brainboxemb/lib.scad.mechint/doc/10-00-plan.md

# lib.scad.mechint plan

## Purpose

This is the operational source for current/future work in the reusable
mechanical-interface library. Completed functional history belongs in
[../CHANGELOG.md](../CHANGELOG.md).

## Current position

The sliding-dovetail interface is the established reusable component. It
supports base male/female mating geometry plus optional entry-slot, locking,
release-access, printable release-shape and centered hinge-relief features.

Migration 011 issue #34 is complete and qualified on exact main. The current
owner step is the `v0.2.4` patch release candidate for that consumer-rollout
baseline.

The release adopts `tool.git-project v0.2.14`, `tool.scad-project v0.15.11`,
`lib.scad.forge v0.3.1` and `lib.scad.util v0.4.1`, together with managed root
launchers, current self/reusable workflow naming and the shared numbered
documentation structure.

No sliding-dovetail geometry or public API semantics change in `v0.2.4`.

## Working method

1. inspect current source, open issues/PRs, live CI and generated evidence;
2. read the component design and manual before changing interface semantics;
3. keep fit dimensions separate from Boolean/modeling overlap;
4. preserve the public top-level API boundary;
5. add product-independent behavior here and product placement in consumers;
6. inspect fit/section evidence when the change is geometric.

## Information sources

| Question | Authority |
| --- | --- |
| Current/future library work | this plan |
| Shared working conventions | `brainboxemb.meta/AGENTS.md` |
| Interface contracts/boundaries | [30-00-specification.md](30-00-specification.md) |
| Repository architecture | [40-00-design.md](40-00-design.md) |
| Detailed geometry | `openscad/sliding-dovetail/design/design.md` |
| Consumer usage/API reference | `openscad/sliding-dovetail/manual.md` |
| Verification strategy/status | [50-00-verification.md](50-00-verification.md) |
| Exact dependency/tool state | config, gitlinks, live Actions and provenance |
| Completed history | [../CHANGELOG.md](../CHANGELOG.md) |
