brainboxemb/lib.scad.mechint/doc/20-02-user.md

# lib.scad.mechint user manual

## Use the library

Consumers import the public entrypoint:

```scad
use <openscad/sliding_dovetail.scad>

joint = sliding_dovetail_create(...);
sliding_dovetail_male_build(joint, slide_len_mm = 16);
sliding_dovetail_female_cutter(joint, slide_len_mm = 16);
```

The same interface object drives mating geometry so male/female dimensions,
clearance, optional entry-slot behavior and lock configuration stay coherent.

## Detailed sliding-dovetail guidance

The full consumer-facing reference remains beside the component source:

- [Sliding-dovetail manual](../openscad/sliding-dovetail/manual.md)
- [Sliding-dovetail design](../openscad/sliding-dovetail/design/design.md)

Use the manual for exact API/usage guidance. Use the design document when the
mechanical construction or coordinate system matters.

## Dependency boundary

`lib.scad.forge` supplies generic modeling mechanics only. Mechanical-interface
fit and locking semantics remain owned by mechint.

`lib.scad.util` is used only for section-inspection views and does not define
the mechanical interface.

## Versions

Pin an explicit released mechint version. The library itself pins exact released
Forge/util/tooling dependencies through `project.yml` plus committed gitlinks.
