brainboxemb/lib.scad.mechint/doc/README.md

# lib.scad.mechint documentation

This directory is the maintained engineering-documentation index for
`lib.scad.mechint`.

The library owns reusable mechanical interfaces. Product-specific placement,
load-path and assembly decisions stay with consumers.

## Reading order

- [10-00 — Plan](10-00-plan.md) — current work, authorities and sequence.
- [20-00 — Manuals](20-00-manuals.md) — development and consumer guidance.
- [20-01 — Development](20-01-development.md) — maintain, qualify and release mechint.
- [20-02 — User](20-02-user.md) — consume the public mechanical-interface API.
- [30-00 — Specification](30-00-specification.md) — interface purpose and contracts.
- [40-00 — Design](40-00-design.md) — repository/API architecture.
- [50-00 — Verification](50-00-verification.md) — reusable-interface qualification.

Sliding-dovetail detailed geometry remains beside source at
[../openscad/sliding-dovetail/design/design.md](../openscad/sliding-dovetail/design/design.md).
The detailed consumer manual remains at
[../openscad/sliding-dovetail/manual.md](../openscad/sliding-dovetail/manual.md).
