brainboxemb/lib.scad.mechint/vrf/openscad/02-sliding-dovetail-approach.scad

use <../../openscad/sliding-dovetail/reference/sliding_dovetail_reference.scad>

reference =
    sliding_dovetail_reference_create();

$vpt = [2, 1.5, 0];
$vpr = [72, 0, 35];
$vpd = 90;

sliding_dovetail_reference_pair_build(
    reference,
    position = "approach"
);
