brainboxemb/lib.scad.mechint/openscad/sliding-dovetail/render/sliding-dovetail-assembled.scad

use <../sliding_dovetail_render.scad>

$vpt = [10, 1.5, 0];
$vpr = [72, 0, 35];
$vpd = 72;

sliding_dovetail_design(view = "assembled");
