brainboxemb/lib.scad.mechint/openscad/sliding-dovetail/render/sliding-dovetail-female.scad

use <../sliding_dovetail_render.scad>

$vpt = [10, 3, 0];
$vpr = [72, 0, 35];
$vpd = 70;

sliding_dovetail_design(view = "female");
