brainboxemb/lib.scad.mechint/openscad/sliding-dovetail/render/sliding-dovetail-lock-male.scad

use <../sliding_dovetail_render.scad>

$vpt = [0, 1.5, 0];
$vpr = [72, 0, 35];
$vpd = 55;

sliding_dovetail_lock_design(view = "male");
