brainboxemb/lib.scad.mechint/openscad/sliding-dovetail/render/sliding-dovetail-pair.scad

use <../sliding_dovetail_render.scad>

$vpt = [2, 1.5, 0];
$vpr = [72, 0, 35];
$vpd = 90;

sliding_dovetail_design(view = "approach");
