brainboxemb/lib.scad.mechint/vrf/fixtures/export/12-sliding-dovetail-lock-female-cutaway.scad

use <../../../openscad/sliding_dovetail.scad>
use <../../../openscad/sliding-dovetail/reference/sliding_dovetail_reference.scad>
use <00-sliding-dovetail-fixture-orientation.scad>

joint =
    sliding_dovetail_create(
        is_locking_enabled = true,
        lock_spring_len_mm = 5.5,
        lock_has_back_clearance = true,
        lock_has_release_access = true
    );

reference =
    sliding_dovetail_reference_create(
        obj = joint
    );

// Keep the +Z half in native coordinates so the center plane exposes the
// threshold and spring cavity, then orient the resulting fixture for viewing.
sliding_dovetail_fixture_female_inspection(reference)
    intersection() {
        sliding_dovetail_reference_female_build(reference);

        translate([-1, -1, 0])
            cube([
                reference.female_block_len_mm + 2,
                reference.female_block_depth_mm + 2,
                reference.block_width_mm / 2 + 1
            ]);
    }
