brainboxemb/lib.scad.mechint/(list of files, cad)

Other CAD files:
openscad/sliding-dovetail/sliding_dovetail.scad
openscad/sliding-dovetail/render/sliding-dovetail-assembled-section.scad
openscad/sliding-dovetail/render/sliding-dovetail-lock-assembled.scad
openscad/sliding-dovetail/render/sliding-dovetail-male.scad
vrf/fixtures/export/00-sliding-dovetail-hinge-fixture.scad
vrf/fixtures/export/13-sliding-dovetail-lock-assembled.scad
vrf/fixtures/export/16-sliding-dovetail-lock-hinge-female-cutaway.scad
vrf/fixtures/export/17-sliding-dovetail-lock-hinge-assembled-cutaway.scad
vrf/fixtures/export/01-sliding-dovetail-male-test-piece.scad
vrf/fixtures/export/02-sliding-dovetail-female-test-block.scad
vrf/fixtures/export/10-sliding-dovetail-lock-male-test-piece.scad
vrf/fixtures/export/11-sliding-dovetail-lock-female-test-block.scad
