brainboxemb/lib.scad.mechint/openscad/sliding-dovetail/manual.md

# Sliding dovetail

The interface is aimed at compact **FDM-printed mechanical parts**.

## Native orientation

```text
X = slide_len_mm / insertion direction
Y = profile depth
Z = profile width_mm

female entry side = -X
insertion motion = +X
female end-stop side = +X
```

The male mouth lies at `Y=0`; the wider root lies toward `+Y`.

## Default interface

| Parameter | Default |
| --- | ---: |
| Root / maximum male width | 10.0 mm |
| Profile height | 3.0 mm |
| Flank angle | 20° |
| Root land depth | 0 mm / disabled |
| Mouth land depth | 0 mm / disabled |
| Derived male mouth width | 7.82 mm |
| Female clearance | 0.20 mm |
| Axial clearance | 0.25 mm |
| Boolean overlap (`extra_mm`) | 0.01 mm |
| Female entry slot | 0 mm / disabled |
| Locking | disabled |

## Parameter meaning

`angle_deg` directly describes the mechanical flank angle.

`root_land_depth_mm` optionally replaces the final part of each angled flank with
a straight land at the wide/root end. `mouth_land_depth_mm` does the same at the
narrow/mouth end before the angled flank begins. Values of `0` preserve the
original trapezoidal profile exactly.

The mouth width is derived from `width_mm`, the remaining sloped depth
`height_mm - root_land_depth_mm - mouth_land_depth_mm`, and `angle_deg`.

The two lands are useful for side-printed parts where a fully angled profile
would otherwise begin or finish on a sharp first-layer edge.

`clearance_mm` and `axial_clearance_mm` are fit dimensions.

`extra_mm` exists only to make OpenSCAD unions and differences robust at shared
boundaries. It is not part of the nominal mating dimensions.

### Female entry slot

`entry_slot_len_mm` optionally adds a straight rectangular subtraction volume
ahead of the female channel on the fixed `-X` entry side. Its width and depth
come from the complete clearanced female root envelope, so a male dovetail can
sit ahead of the channel before sliding in.

The parameter is a length along X only. A value of `0` preserves the ordinary
female cutter. The male builder ignores this setting.

When locking is enabled, a non-zero entry slot also opens the short transverse
relief at the female spring start. This keeps the lock tongue U-shaped even
though material may continue ahead of the mating channel.

For example, a 16 mm male can be given a 16 mm approach pocket:

```scad
joint = sliding_dovetail_create(
    entry_slot_len_mm = 16
);

sliding_dovetail_female_cutter(
    joint,
    slide_len_mm = 16
);
```

`sliding_dovetail_female_slide_len_mm()` continues to return only the mating channel
length. Use `sliding_dovetail_female_total_len_mm()` when host geometry must
include both channel and entry slot.

## Locking

Locking is configured on the same top-level interface object:

```scad
joint = sliding_dovetail_create(
    is_locking_enabled = true,
    lock_has_back_clearance = true,
    lock_has_release_access = true
);
```

The library creates the lower-level lock and spring configuration internally.

`lock_entry_offset_mm` measures the start of the female threshold ramp from the
fixed -X entry side. Its default is 0 mm, so the ramp starts directly at the
edge. In the assembled interface the male recess is derived from that same
entry-side definition.

The lock combines a recess in the male with a ramped threshold in the female
channel roof. Two longitudinal relief cuts form the sides of the U-shaped
tongue. When the spring starts at a physical female edge, that edge is already
the open end of the U. If `lock_entry_offset_mm > 0` or
`entry_slot_len_mm > 0`, the library also cuts the short transverse relief
needed to free the tongue at its entry end.

`lock_has_back_clearance = true` cuts the flex cavity behind the tongue.
With it disabled, the spring can keep a flat outer/rear face.

For a thick host, `lock_spring_hinge_len_mm > 0` enables a **two-sided**
hinge relief. `lock_spring_hinge_thickness_mm` is the total thickness of the
short flex web that remains between the two opposing pockets.

The complete locking-threshold region and the fixed root stay full-depth. From
the fixed root toward the locking lip, both faces use the same profile:

1. a mostly straight root wall;
2. a local 45-degree chamfer;
3. a short flat central-web land;
4. a calculated return ramp;
5. a full-depth flat land under the threshold/lip.

`lock_spring_hinge_len_mm` is split equally between the 45-degree chamfer run
and the flat central-web land. The two pockets remove
`(lock_spring_thickness_mm - lock_spring_hinge_thickness_mm) / 2` from each face,
placing the remaining web around the middle of the tongue. The return-ramp angle
is derived from the remaining spring length and is limited to 45 degrees.

For a 4 mm tongue, `lock_spring_hinge_len_mm = 2` gives the intended 1 x 1 mm
45-degree chamfer followed by 1 mm flat land on each side. A centered web of
about 1 mm would then leave about 1.5 mm relief depth per face. The verification
model keeps the existing 3.3 mm tongue and 0.8 mm web so the same principle can
be inspected at the current library test dimensions. A hinge length of 0 keeps
the previous geometry exactly.

The threshold insertion ramp is independently tunable with
`lock_ramp_len_mm`. With `lock_has_release_access = true`, the recess continues
to the male -X edge with the same width as the recess itself. A small flat
screwdriver can use that opening to lift the female tongue.

The released/default opening is rectangular:

```scad
lock_release_shape = "rectangular"
```

For the side-printed male part the opening can instead use a centered
trapezoidal X/Z profile:

```scad
joint = sliding_dovetail_create(
    is_locking_enabled = true,
    lock_has_release_access = true,
    lock_release_depth_mm = 0.6,
    lock_release_shape = "trapezoid",
    lock_release_taper_angle_deg = 45
);
```

The released rectangular access opening and lock recess are always cut in full.
Trapezoid mode then removes two additional symmetric triangular wedges across
the complete visible release zone, from the male -X/trailing edge through the
far end of the recess. It therefore only removes extra material; it never
narrows or replaces the functional baseline opening.

`lock_release_taper_angle_deg` is measured in the native X/Z profile. At 45
degrees each wedge grows by 1 mm in Z for every 1 mm of nominal release-zone run
in X. The native-Y release depth remains constant. The wedge cutters overlap the baseline opening and extend slightly past the
actual male outer face (including the male body's normal Boolean `extra_mm`)
so coplanar boundaries cannot leave a thin residual wall.

## Male mating relief

A consuming body may overlap the male interface for a robust union while its
flanks still need to remain exposed. Use the profile-derived cutter instead of
duplicating dovetail math:

```scad
difference() {
    consumer_body();

    sliding_dovetail_male_relief_cutter(
        joint,
        slide_len_mm = 16,
        relief_width_mm = 12
    );
}

sliding_dovetail_male_build(joint, slide_len_mm = 16);
```

`relief_width_mm` is the total consumer envelope across native Z that should be
trimmed. The cutter follows the same male profile, including
`root_land_depth_mm` and `extra_mm`; product-specific body placement stays in the
consumer.
