brainboxemb/lib.scad.mechint/doc/20-00-manuals.md

# lib.scad.mechint manuals

Practical guidance is split by audience:

- [20-01 — Development](20-01-development.md) — contributors and maintainers;
- [20-02 — User](20-02-user.md) — consumers of the reusable mechanical API.

The detailed sliding-dovetail consumer reference remains beside source at
[../openscad/sliding-dovetail/manual.md](../openscad/sliding-dovetail/manual.md).
Shared repository/Git/SCAD rules are linked rather than duplicated locally.
