brainboxemb/lib.scad.mechint/(commit log)

2026-09-20 Add sliding dovetail mechanical interface (#1)
    Introduce the first reusable mechanical interface, integral lock support, verification fixtures, release workflow, and v0.1.0 changelog.
    [00-sliding-dovetail-fixture-orientation.scad, 01-sliding-dovetail-fit.scad, 01-sliding-dovetail-male-test-piece.scad, 02-sliding-dovetail-approach.scad, 02-sliding-dovetail-female-test-block.scad, 03-sliding-dovetail-yz-section.scad, 10-sliding-dovetail-lock-male-test-piece.scad, 10-sliding-dovetail-lock-section.scad]
2026-09-20 Add README preview images (#2)
    Mirror the lib.scad.hub75 README preview pattern with generated assembled and lock-section images.
2026-09-20 Use dovetail pair in README preview (#3)
    Replace the assembled preview with the clearer male/female dovetail pair image.
2026-09-20 Add female dovetail entry slot (#5)
    * Add female dovetail entry slot
    * Fix entry-slot verification import
    [04-sliding-dovetail-entry-slot.scad, sliding_dovetail.scad, sliding_dovetail_api.scad, sliding_dovetail_reference.scad, sliding_dovetail_test_assembly.scad]
2026-09-20 Fix lock tongue relief with female entry slot (#7)
    [11-sliding-dovetail-lock-entry-slot-spring.scad, sliding_dovetail.scad, sliding_dovetail_api.scad, sliding_dovetail_lock.scad]
2026-09-20 Add printable root land and male mating relief (#9)
    [12-sliding-dovetail-root-land-relief.scad, sliding_dovetail.scad, sliding_dovetail_api.scad]
2026-09-20 Add configurable dovetail mouth land (#11)
    [13-sliding-dovetail-mouth-root-land.scad, sliding_dovetail.scad, sliding_dovetail_api.scad]
2026-09-20 Add print-friendly spring hinge relief (#13)
    * Add print-friendly spring hinge relief
    * Guard lock hinge from threshold overlap
    [14-sliding-dovetail-lock-hinge-relief.scad, main.scad, sliding_dovetail.scad, sliding_dovetail_api.scad, sliding_dovetail_lock.scad]
2026-09-20 Refine spring hinge relief and add clear evidence (#15)
    * Add clear hinge-relief evidence and fixtures
    * Fix hinge fixture helper ownership
    * Regenerate hinge evidence for 45-degree relief
    * Consolidate final hinge geometry and evidence
    * Support locking lip with full-depth threshold land
    * Shorten flex land and cap return ramp at 45 degrees
    * Make fixed-root 45-degree feature a local chamfer
    * Scale root chamfer and flex land as equal pair
    * Center spring flex web with opposing relief pockets
    [00-sliding-dovetail-hinge-fixture.scad, 14-sliding-dovetail-lock-hinge-relief.scad, 15-sliding-dovetail-lock-hinge-female.scad, 15-sliding-dovetail-lock-hinge-overview.scad, 16-sliding-dovetail-lock-hinge-cutaway.scad, 16-sliding-dovetail-lock-hinge-female-cutaway.scad, 17-sliding-dovetail-lock-hinge-assembled-cutaway.scad, sliding_dovetail.scad]
2026-09-21 Add printable male lock-release wedges (#17)
    Add symmetric print-optimized release wedges while preserving the rectangular functional release opening.
    [sliding_dovetail.scad, sliding_dovetail_api.scad, sliding_dovetail_lock.scad]
2026-09-21 refactor(scad): align mechint API with shared coding standard
    [00-sliding-dovetail-hinge-fixture.scad, 04-sliding-dovetail-entry-slot.scad, 10-sliding-dovetail-lock-male-test-piece.scad, 10-sliding-dovetail-lock-section.scad, 11-sliding-dovetail-lock-entry-slot-spring.scad, 11-sliding-dovetail-lock-female-test-block.scad, 12-sliding-dovetail-lock-female-cutaway.scad, 12-sliding-dovetail-root-land-relief.scad]
2026-09-21 Fix coding-standard verification consumers
    [00-sliding-dovetail-fixture-orientation.scad, 00-sliding-dovetail-hinge-fixture.scad, 04-sliding-dovetail-entry-slot.scad, 10-sliding-dovetail-lock-male-test-piece.scad, 10-sliding-dovetail-lock-section.scad, 11-sliding-dovetail-lock-entry-slot-spring.scad, 11-sliding-dovetail-lock-female-test-block.scad, 12-sliding-dovetail-lock-female-cutaway.scad]
2026-09-21 Correct reference verification renames
    [00-sliding-dovetail-fixture-orientation.scad, 00-sliding-dovetail-hinge-fixture.scad, 12-sliding-dovetail-lock-female-cutaway.scad, 14-sliding-dovetail-lock-assembled-cutaway.scad, 14-sliding-dovetail-lock-hinge-relief.scad]
2026-09-21 refactor(scad): adopt Forge modeling helpers
    [sliding_dovetail.scad, sliding_dovetail_lock.scad]
2026-09-21 fix(vrf): qualify Forge util dependency pin
2026-09-21 refactor(scad): use xf helpers for core placement
    [sliding_dovetail.scad, sliding_dovetail_lock.scad]
2026-09-21 refactor(scad): replace raw axis matrices with xf frames
    [sliding_dovetail.scad, sliding_dovetail_lock.scad]
2026-09-21 chore(scad): pin released util v0.3.0
2026-09-21 refactor(scad): adopt util v0.4 overlap tokens
    [sliding_dovetail_lock.scad]
2026-09-22 refactor(scad): migrate modeling layer to Forge
    [sliding_dovetail.scad, sliding_dovetail_lock.scad]
2026-09-22 chore(scad): pin Forge v0.2.1
    [sliding_dovetail_lock.scad]
2026-09-22 refactor(scad): promote public API entrypoint
    [00-sliding-dovetail-hinge-fixture.scad, 04-sliding-dovetail-entry-slot.scad, 10-sliding-dovetail-lock-male-test-piece.scad, 10-sliding-dovetail-lock-section.scad, 11-sliding-dovetail-lock-entry-slot-spring.scad, 11-sliding-dovetail-lock-female-test-block.scad, 12-sliding-dovetail-lock-female-cutaway.scad, 12-sliding-dovetail-root-land-relief.scad]
2026-09-22 docs(scad): name sliding-dovetail design orientation
    [sliding_dovetail.scad]
2026-09-23 Apply Migration 010 mechint documentation model (#33)
    * docs(mechint): apply Migration 010 audit
    * docs(mechint): preserve visual README preview
    [sliding_dovetail.scad]
